playfultechnology/pid-balanceplate/Schematics/Bottom plate.pdf

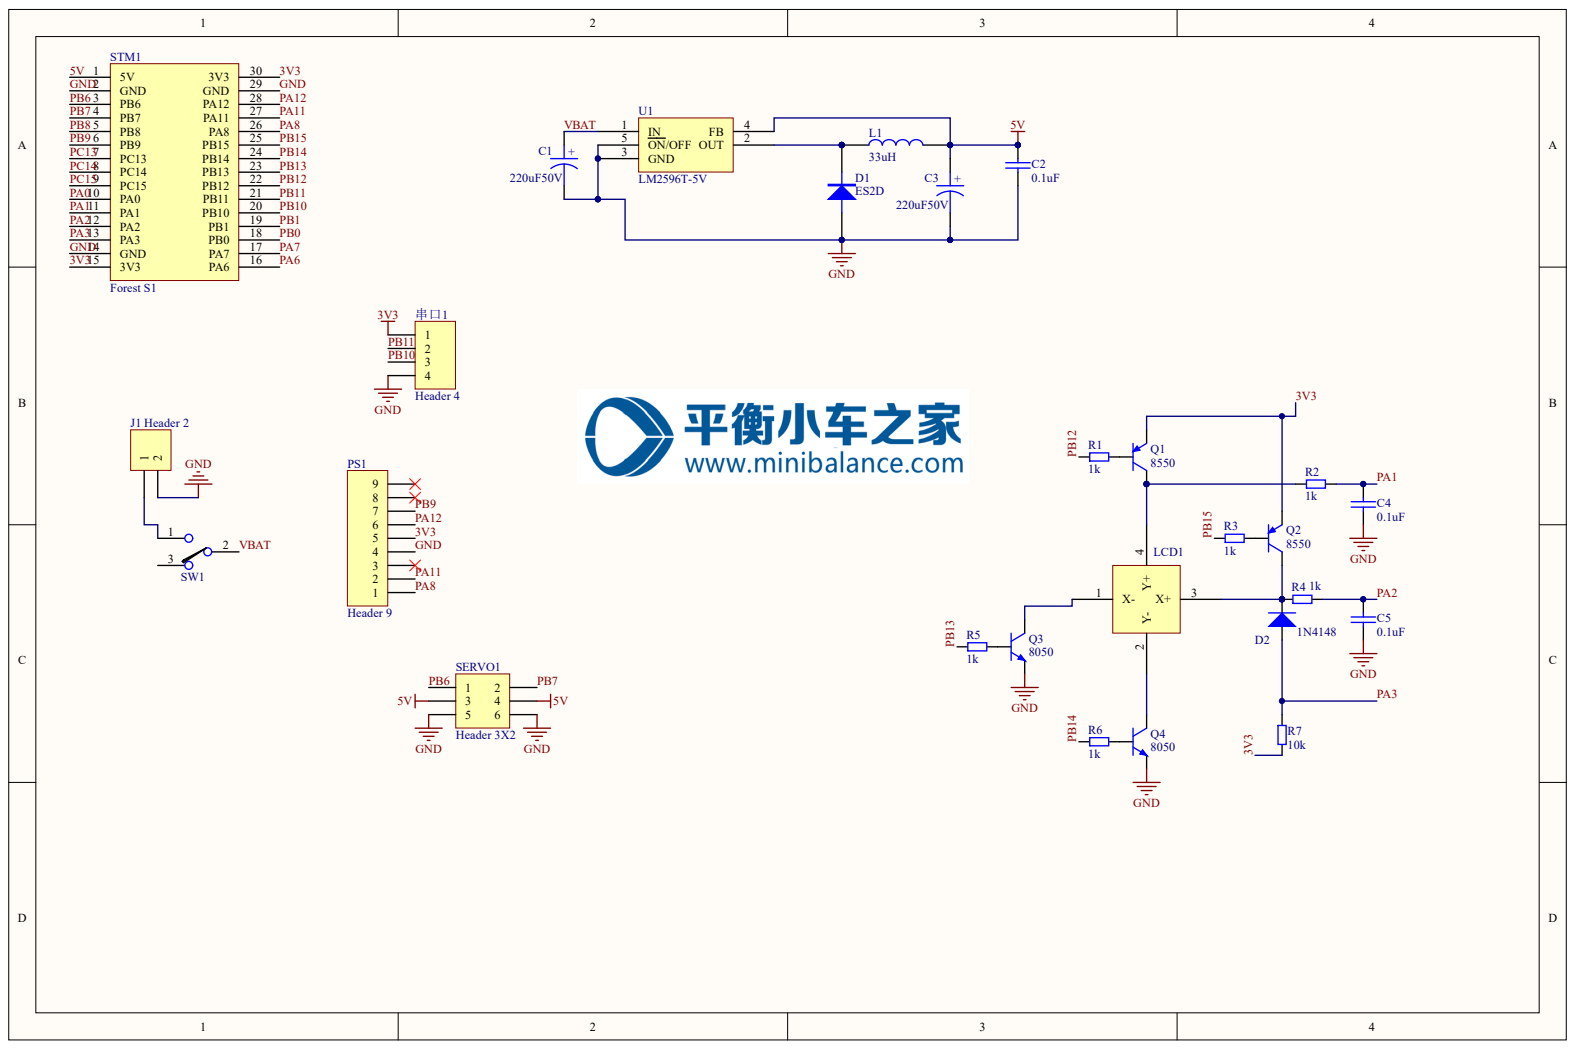
[picture p6: page 1]
