playfultechnology/pid-balanceplate/download/STM32板球系统/电阻屏驱动模块附送资料/电阻屏驱动模块原理图.pdf

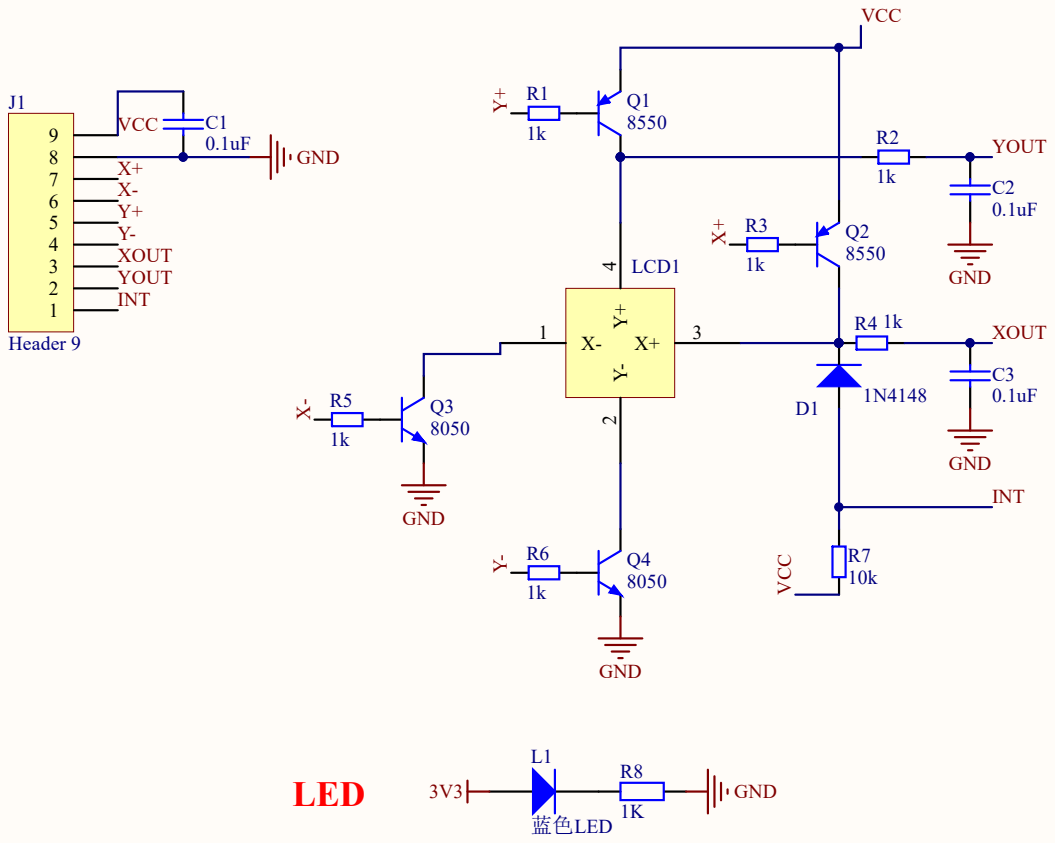
[picture p7: page 1]
