playfultechnology/pid-balanceplate/STM32 Source Code/HARDWARE/EXTI/exti.c

#include "exti.h"
  /**************************************************************************
作者：平衡小车之家
我的淘宝小店：http://shop114407458.taobao.com/
**************************************************************************/
/**************************************************************************
函数功能：触摸屏初始化
入口参数：无 
返回  值：无
**************************************************************************/
void Screen_Init(void)
{
  GPIO_InitTypeDef GPIO_InitStructure;
  RCC_APB2PeriphClockCmd(RCC_APB2Periph_GPIOB, ENABLE); //使能端口时钟
  GPIO_InitStructure.GPIO_Pin = GPIO_Pin_12|GPIO_Pin_13|GPIO_Pin_14|GPIO_Pin_15;//端口配置
  GPIO_InitStructure.GPIO_Mode = GPIO_Mode_Out_PP;      //推挽输出
	GPIO_InitStructure.GPIO_Speed = GPIO_Speed_50MHz;     //50M
  GPIO_Init(GPIOB, &GPIO_InitStructure);					      //根据设定参数初始化GPIOA 
}
/**************************************************************************
函数功能：外部中断初始化
入口参数：无
返回  值：无 
**************************************************************************/
void MiniBalance_EXTI_Init(void)
{  
		GPIO_InitTypeDef GPIO_InitStructure;
		EXTI_InitTypeDef EXTI_InitStructure;
		NVIC_InitTypeDef NVIC_InitStructure;
		RCC_APB2PeriphClockCmd(RCC_APB2Periph_AFIO,ENABLE);//外部中断，需要使能AFIO时钟
		RCC_APB2PeriphClockCmd(RCC_APB2Periph_GPIOA, ENABLE); //使能GPIO端口时钟
		GPIO_InitStructure.GPIO_Pin = GPIO_Pin_3;	            //端口配置
		GPIO_InitStructure.GPIO_Mode = GPIO_Mode_IPU;         //上拉输入
		GPIO_Init(GPIOA, &GPIO_InitStructure);					      //根据设定参数初始化GPIO
  	GPIO_EXTILineConfig(GPIO_PortSourceGPIOA,GPIO_PinSource3);
  	EXTI_InitStructure.EXTI_Line=EXTI_Line3;
  	EXTI_InitStructure.EXTI_Mode = EXTI_Mode_Interrupt;	
  	EXTI_InitStructure.EXTI_Trigger = EXTI_Trigger_Falling;//下降沿触发
  	EXTI_InitStructure.EXTI_LineCmd = ENABLE;
  	EXTI_Init(&EXTI_InitStructure);	 	//根据EXTI_InitStruct中指定的参数初始化外设EXTI寄存器
		NVIC_InitStructure.NVIC_IRQChannel = EXTI3_IRQn;			//使能按键所在的外部中断通道
  	NVIC_InitStructure.NVIC_IRQChannelPreemptionPriority = 0x01;	//抢占优先级2， 
  	NVIC_InitStructure.NVIC_IRQChannelSubPriority = 0x01;					//子优先级1
  	NVIC_InitStructure.NVIC_IRQChannelCmd = ENABLE;								//使能外部中断通道
  	NVIC_Init(&NVIC_InitStructure); 
}


void EXTI3_IRQHandler(void) 
{    
	 if(INT==0)		
	{   
		  EXTI->PR=1<<3;                               //清除中断标志位   
		Flag_Stop=0;
	}
}
